Suleiman700/esp32-obd2-logger/case/v2/lid_shift5.5.stl

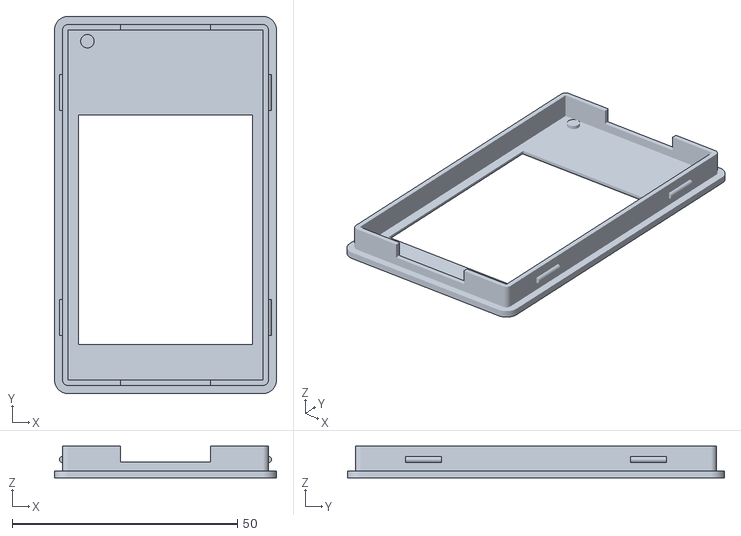
[picture p22: CAD file, 2026-10-13]
case/v2/lid_shift5.5.stl
49.3 x 83.8 x 7.10
