Suleiman700/esp32-obd2-logger/case/v2/box_original_vents.stl

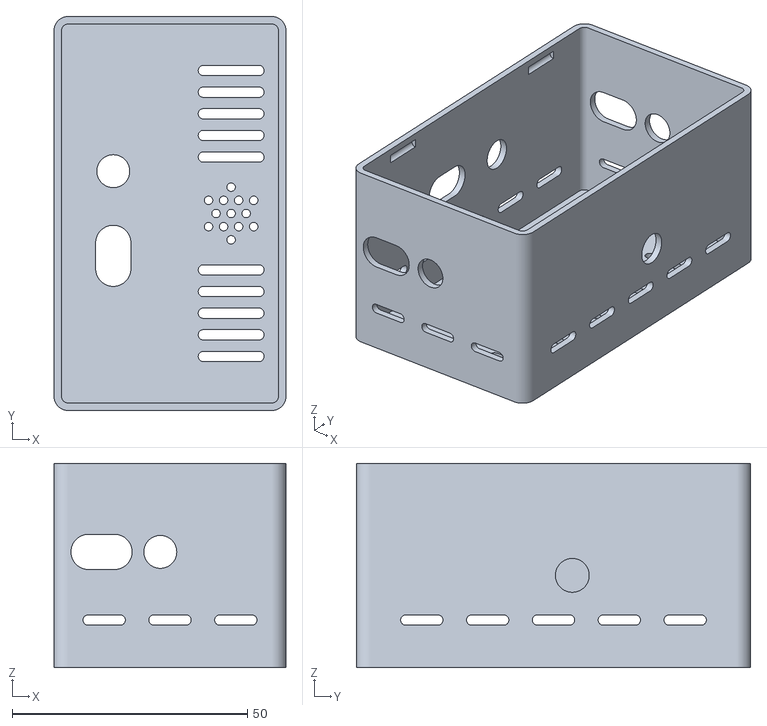
[picture p23: CAD file, 2026-10-13]
case/v2/box_original_vents.stl
49.3 x 83.8 x 43.4
