Suleiman700/esp32-obd2-logger/(list of files, cad)

Other CAD files:
case/archive/lid_v1_centered.stl
