Suleiman700/esp32-obd2-logger/docs/wiring.png

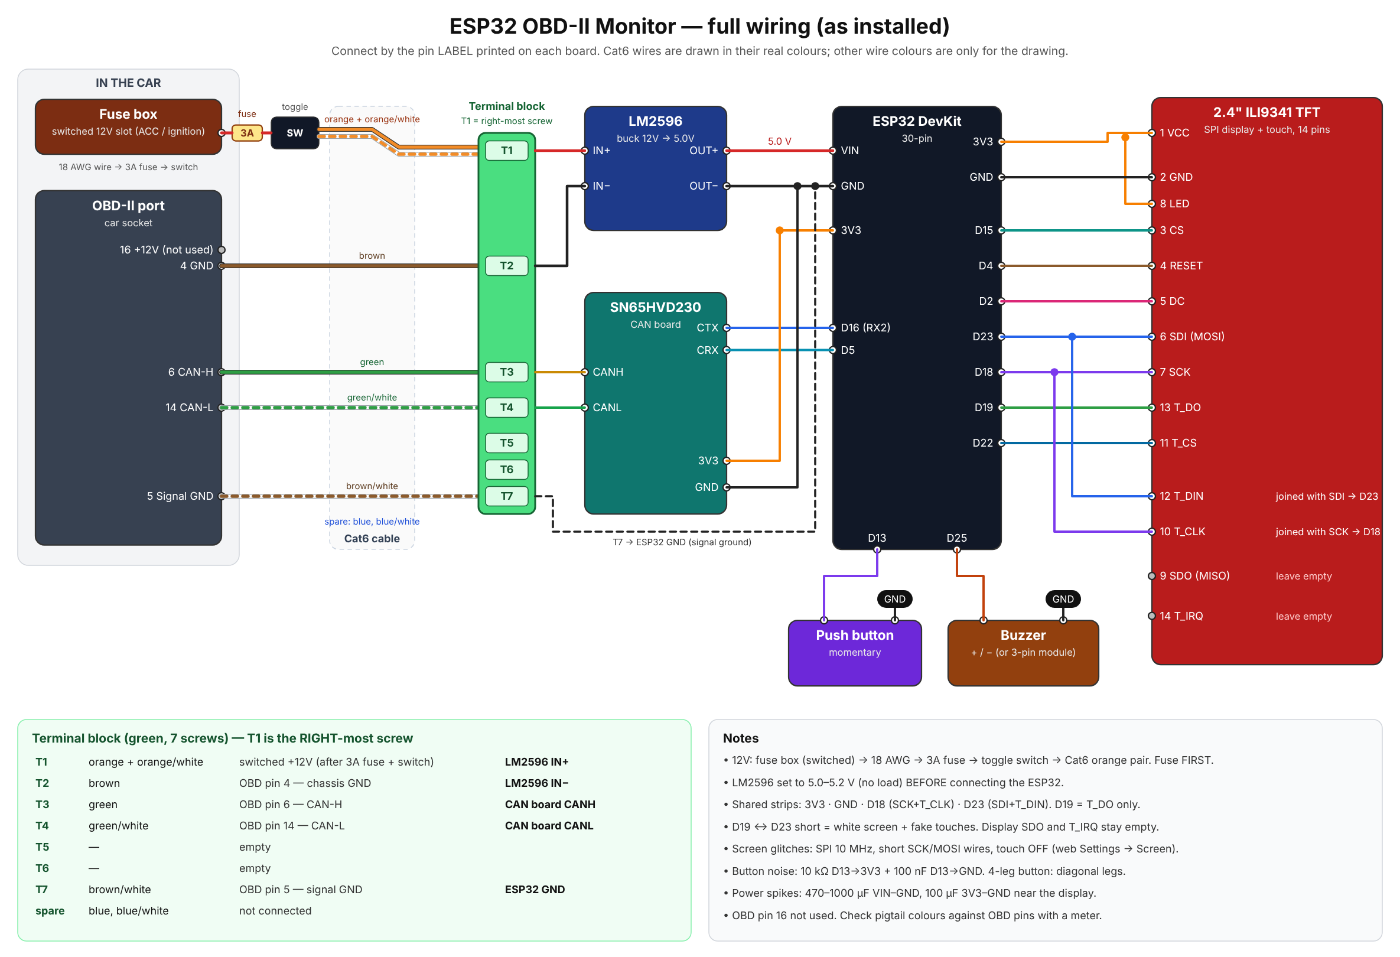
docs/wiring.png
