Suleiman700/esp32-obd2-logger/(commit log)

2026-10-13 ESP32 OBD-II monitor: firmware v3.0 and case v2
    Claude-Session: https://claude.ai/code/session_01RPQw6btHRV2FXbZkCgycn1
    [box_honeycomb.stl, box_original_vents.stl, lid_shift5.5.stl]
2026-10-13 Docs: screens, web panel, DEMO/LIVE/LOST, parts sizes, wiring diagram, case images
    - README rewritten as a generic OBD-II monitor
    - Screen mockups for DEMO / LIVE / LOST / alert and every page
    - Web panel screenshots (hotspot control panel)
    - Parts table with the sizes used for the case
    - Wiring table + docs/wiring.svg
    - Case renders: vents box, honeycomb box, original vs shifted lid
    - Original centred lid kept in case/archive
    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
    [lid_v1_centered.stl]
2026-10-13 Docs: assembled case renders, drop back views
    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
2026-10-13 Fix original lid: use the real centred v1 lid, add lid comparison
    The archived v1 lid was accidentally the same file as the shifted lid
    (the generator overwrote case_lid.stl). Restored the real first lid,
    re-rendered it, and documented the differences. Removed location hints.
    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
    [lid_v1_centered.stl]
2026-10-16 Firmware v3.1: own touch handling and 3-tap calibration
    - Map XPT2046 raw values with our own calibration (works in landscape)
    - Lower pressure threshold (300 instead of the library's 600)
    - New 3-cross calibration with a short test afterwards
    - Start calibration from the web panel (Settings) - no touch needed
    - /api/touch shows live raw touch values; Serial logs every touch
    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
    [config.h, display.h, obd_monitor.ino, touchui.h, web.h]
2026-10-16 Firmware v3.2: calibration crosses moved inward, bigger, with live diagnostics
    - Crosses 45 px from the edges so the case frame doesn't block the finger
    - Thicker crosses, button must be held 0.3 s to cancel
    - Serial prints the pressure every second while waiting for a press
    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
    [config.h, display.h, obd_monitor.ino, touchui.h]
2026-10-16 Wiring: as-installed diagram with Cat6 colours and terminal block
    - New docs/wiring.svg (+ PNG): car side, 3A fuse, toggle switch, Cat6 pairs, T1-T7
    - README: terminal block table, shared strips table, updated power path
    - WIRING.txt updated to match
    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
2026-10-16 Firmware v3.3: display glitch recovery, touch on/off, 10 MHz SPI
    - Web panel Settings > Screen: touch on/off, auto repaint (30 s / 1 min / 5 min)
    - 'Repaint screen now' button re-starts the display without rebooting
    - Touch pressed non-stop for 8 s is ignored (case lid pressing the screen)
    - User_Setup.h: SPI 10 MHz (more reliable with jumper wires)
    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
    [User_Setup.h, config.h, display.h, obd_monitor.ino, settings.h, state.h, web.h]
2026-10-16 Firmware v3.4: update over WiFi (OTA) from the web panel + ready-made binaries
    - Settings > Firmware update: upload .bin, protected by the hotspot password,
    progress bar on the screen, auto restart
    - Storage task pauses during the update
    - firmware/bin: full image (flash at 0x0) for the first install and OTA image
    - Panel shows the current firmware version
    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
2026-10-16 Firmware v3.5: noise-proof push button, no automatic touch calibration
    - Button press needs 200 ms released + 80 ms held; glitches ignored
    - Button held/shorted for 3 s is ignored until released (no phantom page cycling)
    - Touch calibration is never started at power-on (web panel only)
    - Settings > Screen: push button on/off; /api/touch shows live button state
    - New binaries in firmware/bin
    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
    [config.h, obd_monitor.ino, settings.h, state.h, web.h]
2026-10-16 Docs: updated wiring notes, troubleshooting, mock ESP32 data for n8n
    - Wiring diagram notes: touch off, button noise filter, capacitors, D19/D23
    - README + WIRING.txt troubleshooting table from the real build
    - integrations/home-assistant/mock: fake ESP32 stream workflow, pin data, sample JSON + curl
    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
2026-10-19 Firmware v3.6: main screen editor (layouts, big/small values) + buzzer/stream/alert test buttons
    - DASH page now uses 5 layouts and 8 value slots set from the hotspot panel (Main screen tab)
    - New default: big Coolant + Speed, small RPM / Fuel / Battery / Throttle
    - Values turn red when their alert rule is active
    - Settings > Tests: buzzer test/stop, test stream POST, test alert POST ("test":true)
    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
    [alerts.h, config.h, display.h, settings.h, state.h, web.h]
2026-10-19 Firmware v3.6.1: main screen icons (text / icon / icon + text) and label colour picker
    - 13 big drawn icons (coolant, speed, RPM, fuel, battery, throttle, oil, load, ...)
    - Tall slot uses the 75 px font; values fall back to smaller fonts when too wide
    - Main screen tab: label mode select + colour picker with swatches
    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
    [config.h, display.h, icons.h, settings.h, state.h, web.h]
2026-10-23 Firmware v3.6.2: push button disabled, auto page cycle, page buttons in the panel
    - USE_BUTTON 0: button pin is never read (touching it did glitch/restart the screen)
    - Settings: change pages automatically (10/20/30/60 s), optional stay on DASH while moving
    - Live tab: DASH / FAV / ALERTS / WIFI buttons switch the device screen
    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
    [config.h, display.h, obd_monitor.ino, settings.h, state.h, touchui.h, web.h]
